NORI-Works/2ch-cw-memory-keyer/2ch-cw-memory-keyer_Schematic.pdf

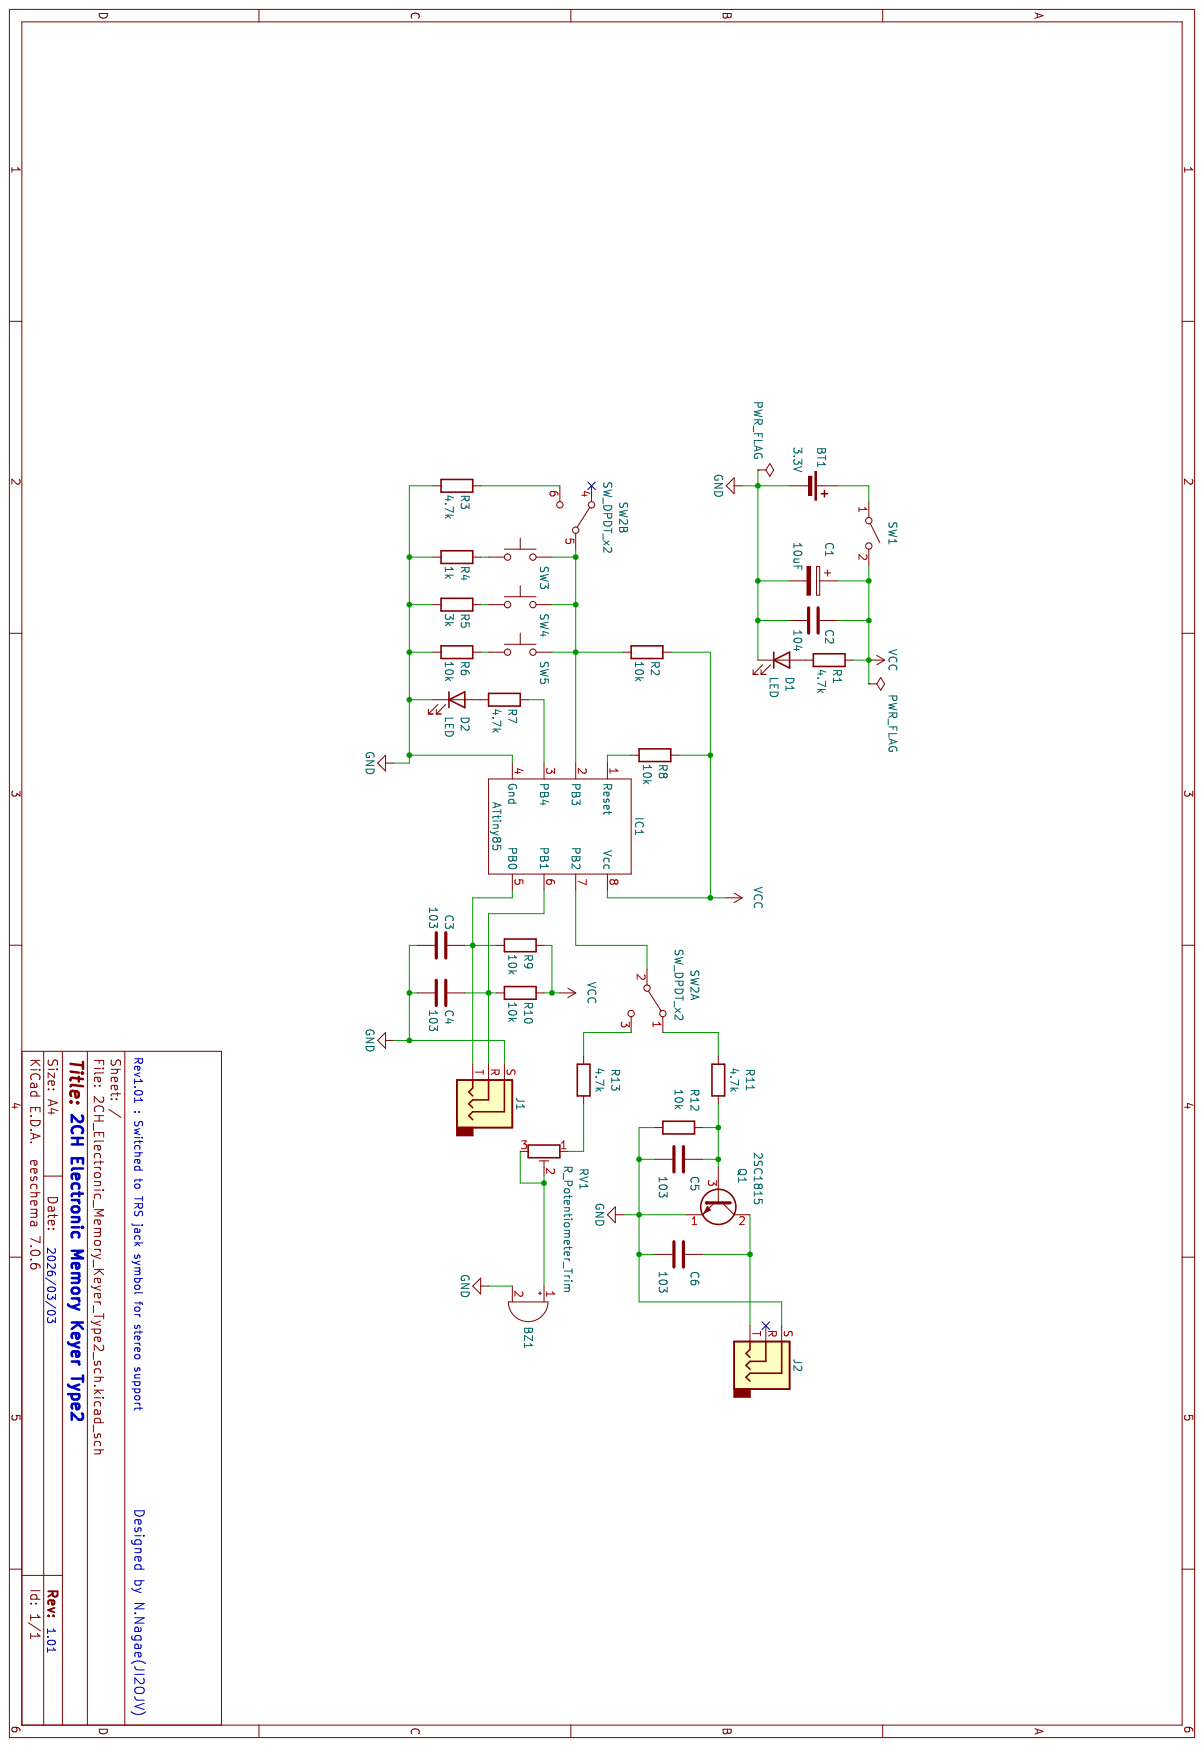
[picture p4: page 1]
