NORI-Works/2ch-cw-memory-keyer/(commit log)

2026-04-23 README小変更
2026-04-24 [EK_T2]コメント変更＆追加
2026-04-26 [EK_T2]コメント&回路図変更
    README.md
    Schematic変更
2026-04-26 [EK_T2]コメント修正
